fulippo/hatchanger/docs/images/front_body_filamatrix.png

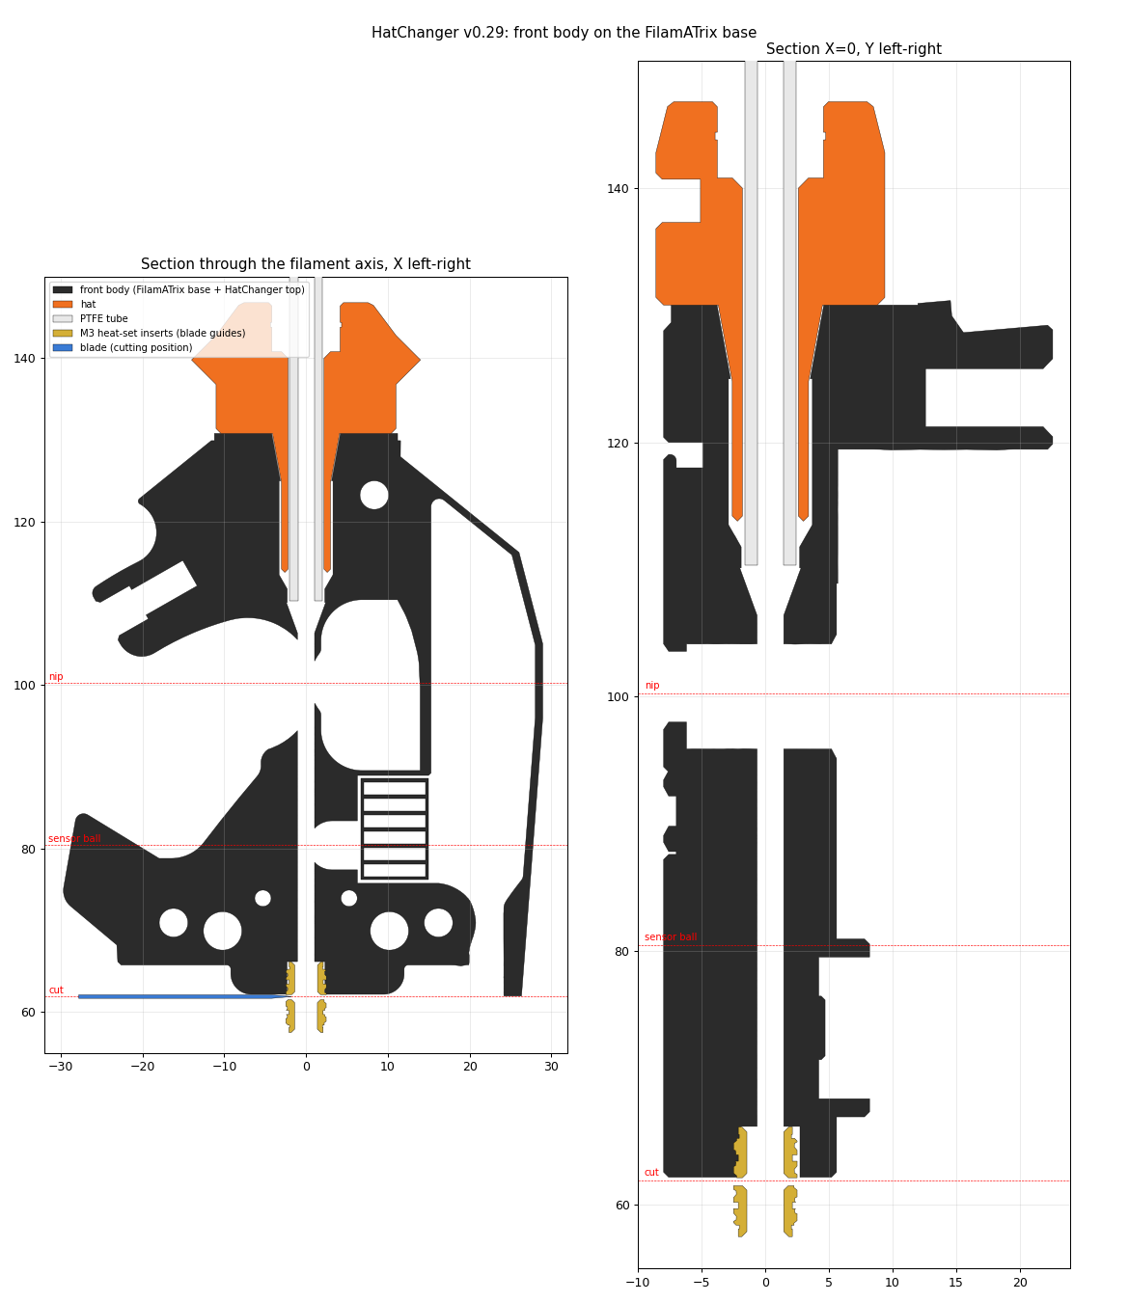
docs/images/front_body_filamatrix.png
