fulippo/hatchanger/docs/images/hat_onepiece_section.png

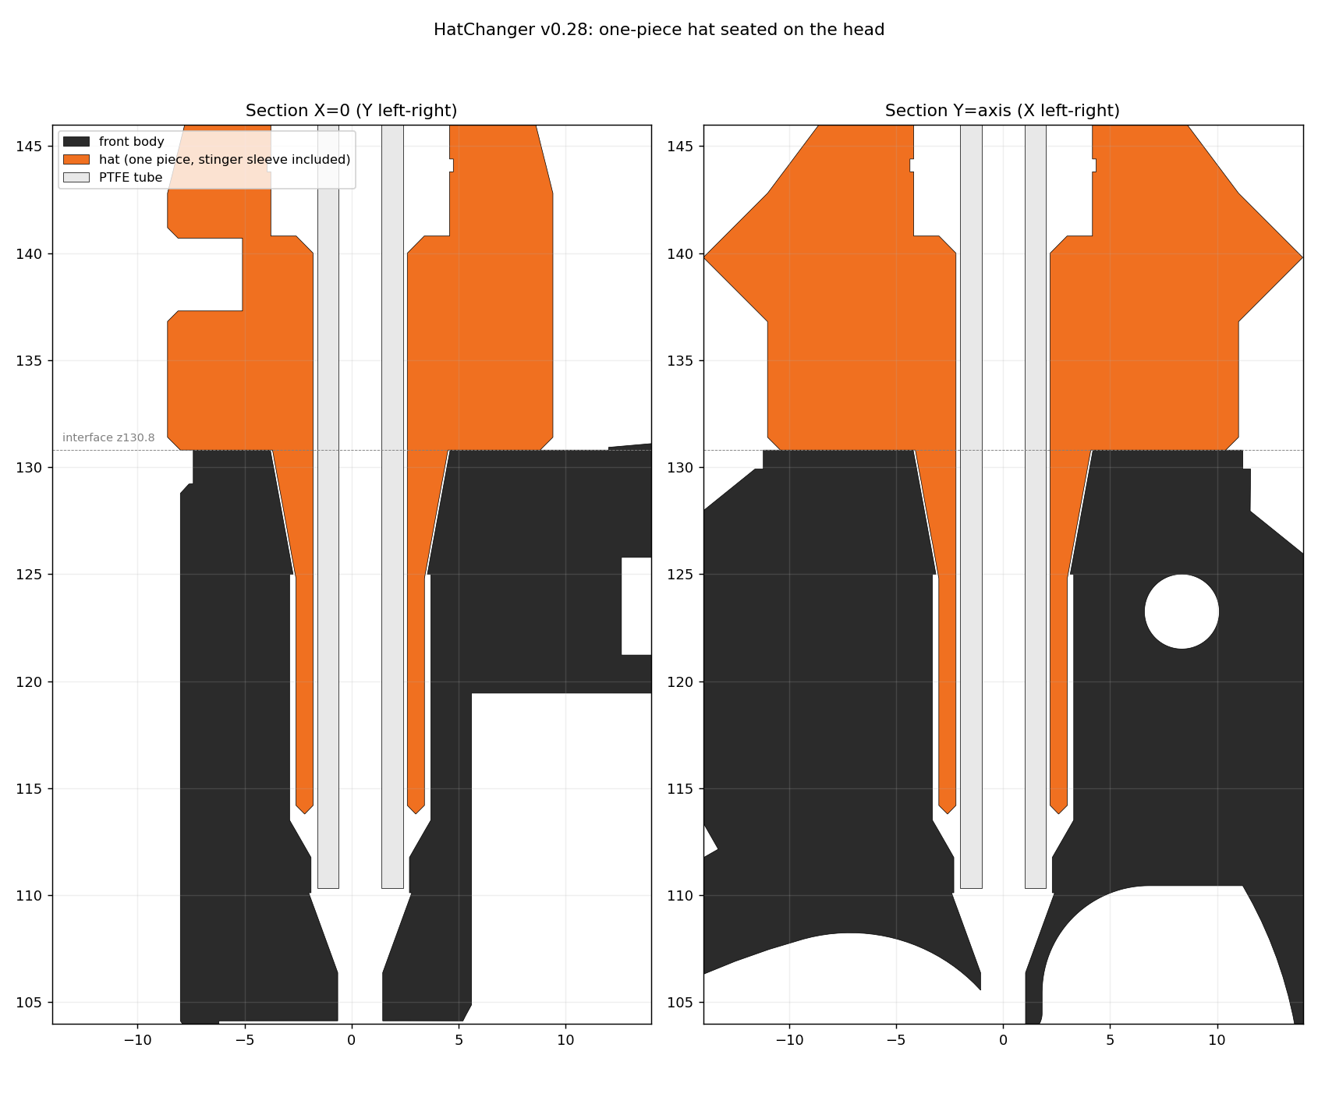
docs/images/hat_onepiece_section.png
