fulippo/hatchanger/docs/images/hat_rack.png

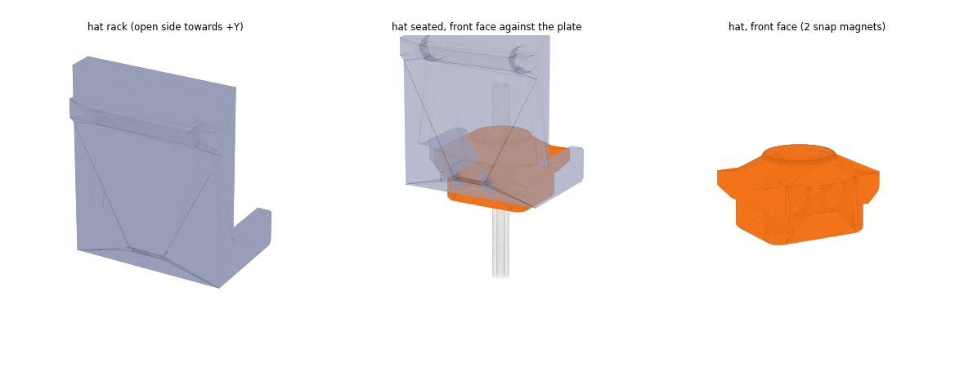
docs/images/hat_rack.png
