fulippo/hatchanger/docs/images/ptfe_rail_clamp.png

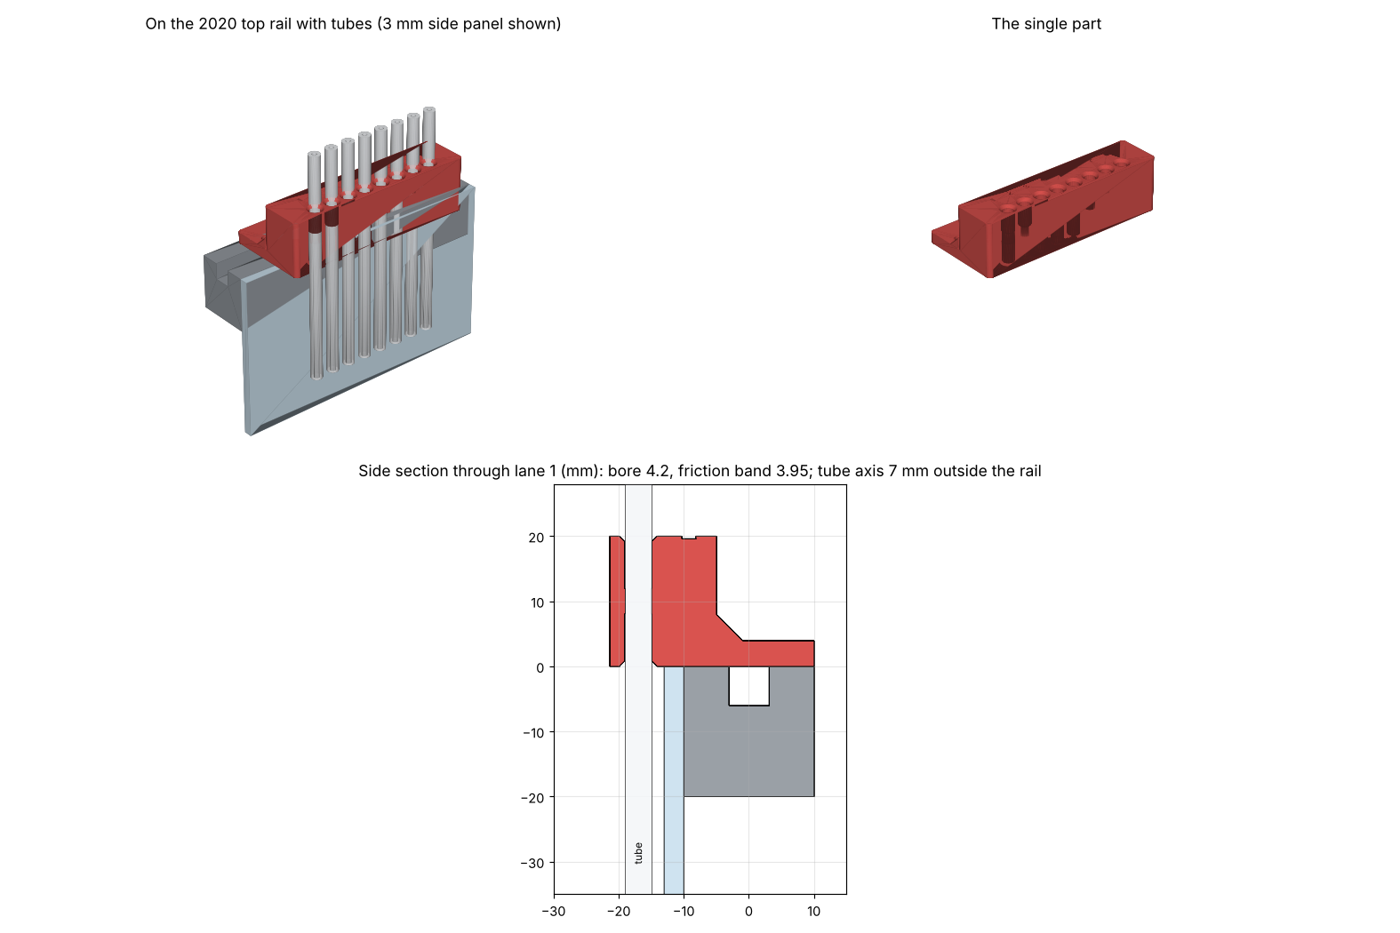
docs/images/ptfe_rail_clamp.png
