fulippo/hatchanger/cad/hatchanger/step/stinger_gauge.step

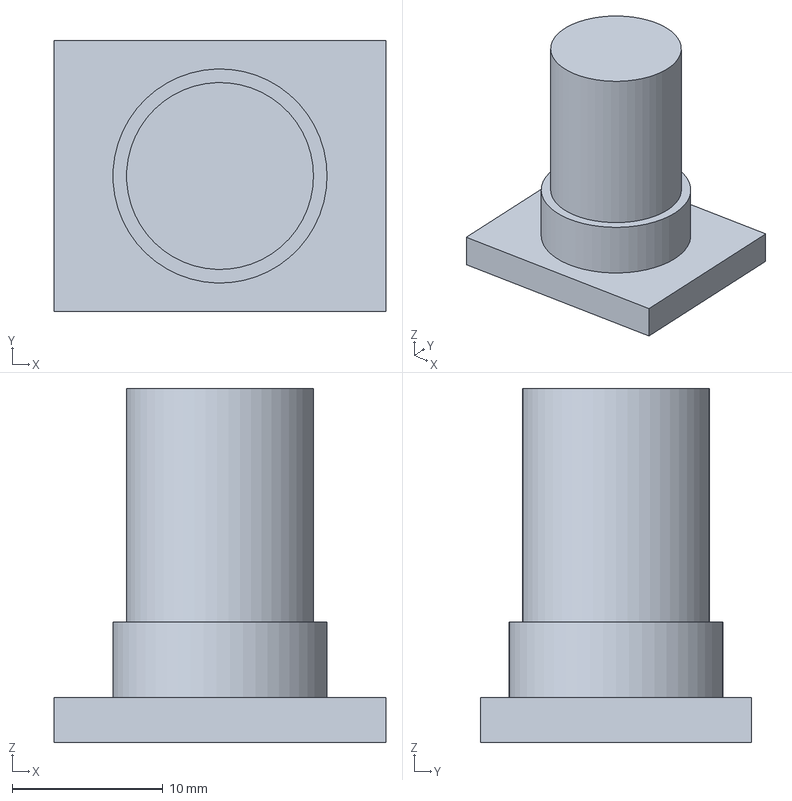
[picture p14: CAD file, 2026-10-16]
cad/hatchanger/step/stinger_gauge.step
22.0 x 18.0 x 23.5 mm
