fulippo/hatchanger/cad/tophat/step/250/tophat_250_centre_rear.step

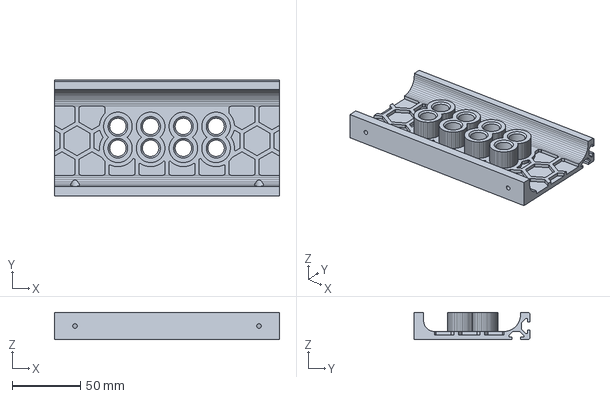
[picture p16: CAD file, 2026-10-20]
cad/tophat/step/250/tophat_250_centre_rear.step
165.0 x 85.0 x 20.0 mm
