fulippo/hatchanger/cad/tophat/step/350/tophat_350_centre_rear.step

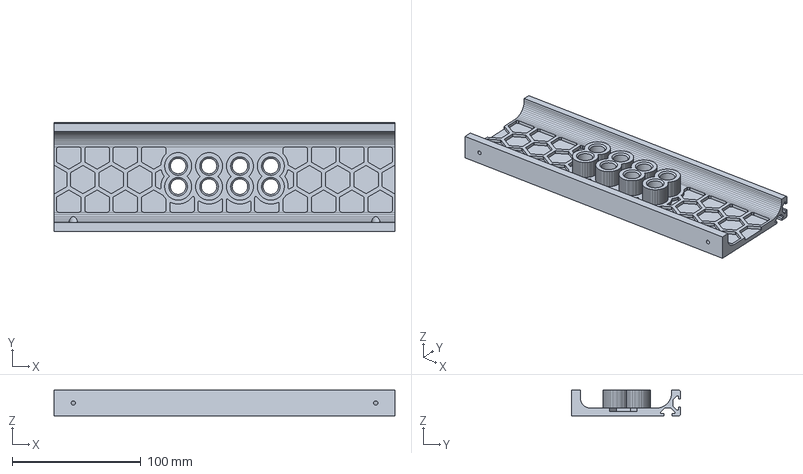
[picture p18: CAD file, 2026-10-20]
cad/tophat/step/350/tophat_350_centre_rear.step
265.0 x 85.0 x 20.0 mm
