fulippo/hatchanger/cad/tophat/step/tophat_grommet_tpu.step

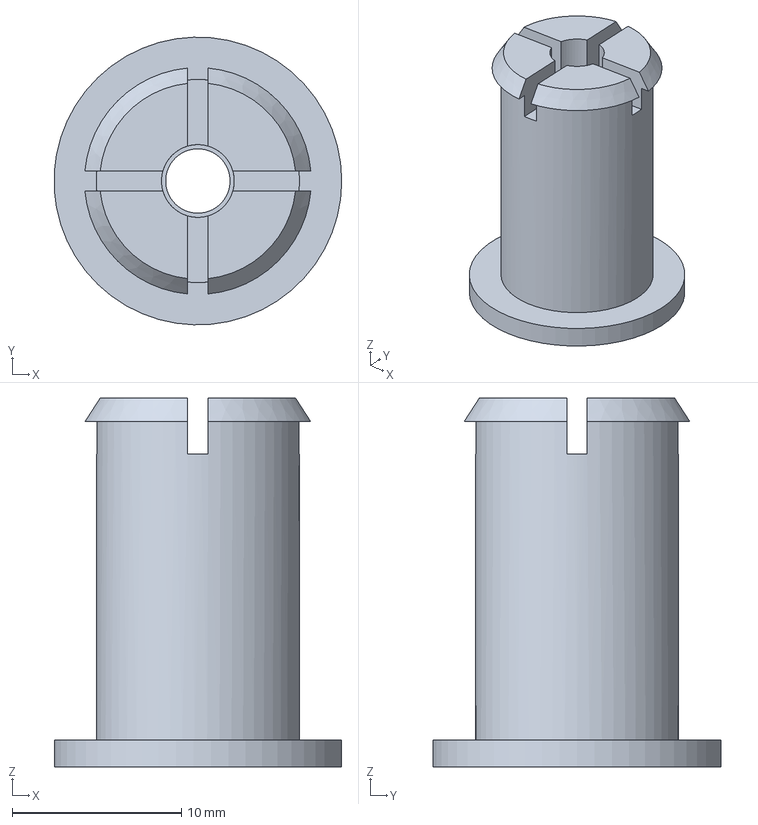
[picture p19: CAD file, 2026-10-20]
cad/tophat/step/tophat_grommet_tpu.step
17.0 x 17.0 x 21.8 mm
