fulippo/hatchanger/cad/hatchanger/step/hat_rack_spacer_12.step

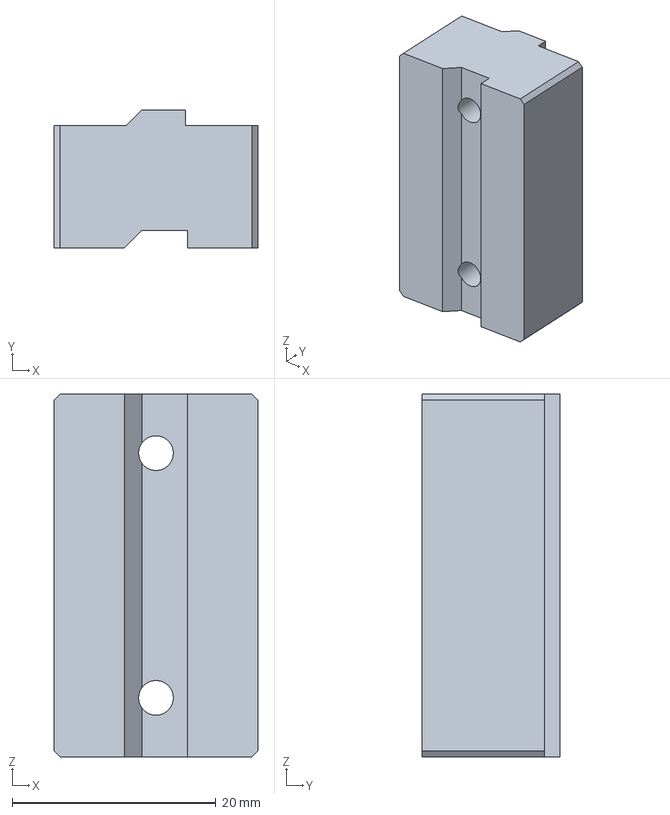
[picture p20: CAD file, 2026-10-16]
cad/hatchanger/step/hat_rack_spacer_12.step
20.0 x 13.5 x 35.6 mm
