fulippo/hatchanger/cad/ptfe_rail_clamp/step/ptfe_rail_clamp_4x.step

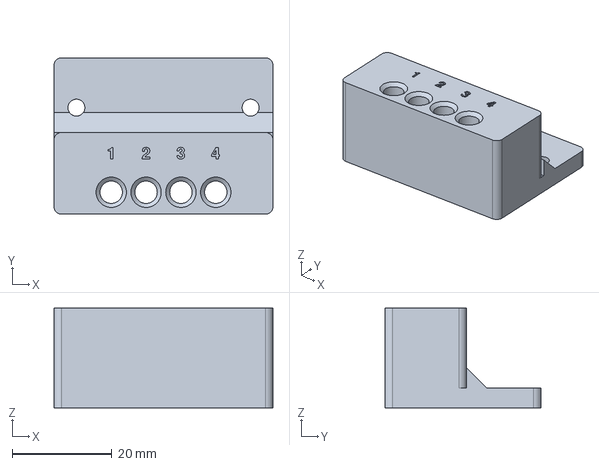
[picture p21: CAD file, 2026-10-16]
cad/ptfe_rail_clamp/step/ptfe_rail_clamp_4x.step
44.0 x 31.4 x 20.0 mm
