fulippo/hatchanger/cad/tophat/step/300/tophat_300_centre_voronoi.step

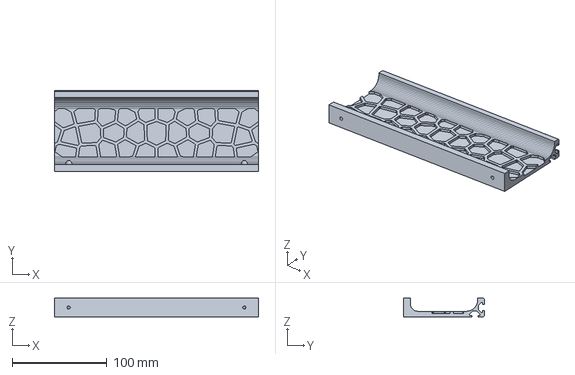
[picture p22: CAD file, 2026-10-20]
cad/tophat/step/300/tophat_300_centre_voronoi.step
215.0 x 85.0 x 20.0 mm
