fulippo/hatchanger/cad/hatchanger/step/hat.step

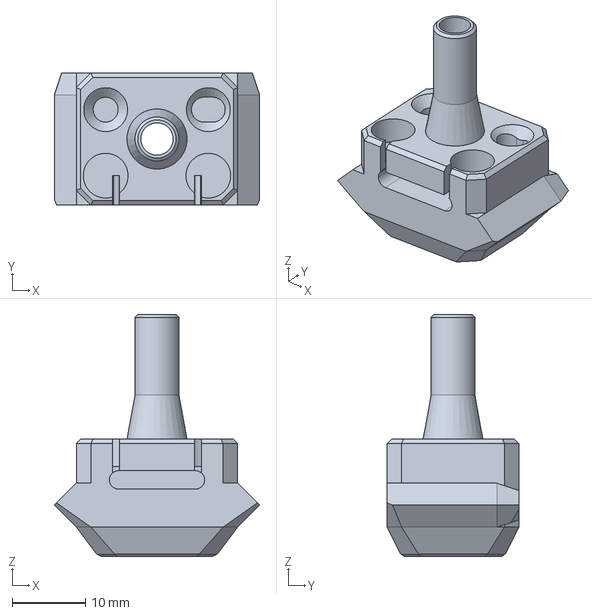
[picture p25: CAD file, 2026-10-16]
cad/hatchanger/step/hat.step
28.0 x 18.0 x 33.0 mm
