fulippo/hatchanger/cad/tophat/step/250/tophat_250_centre_voronoi.step

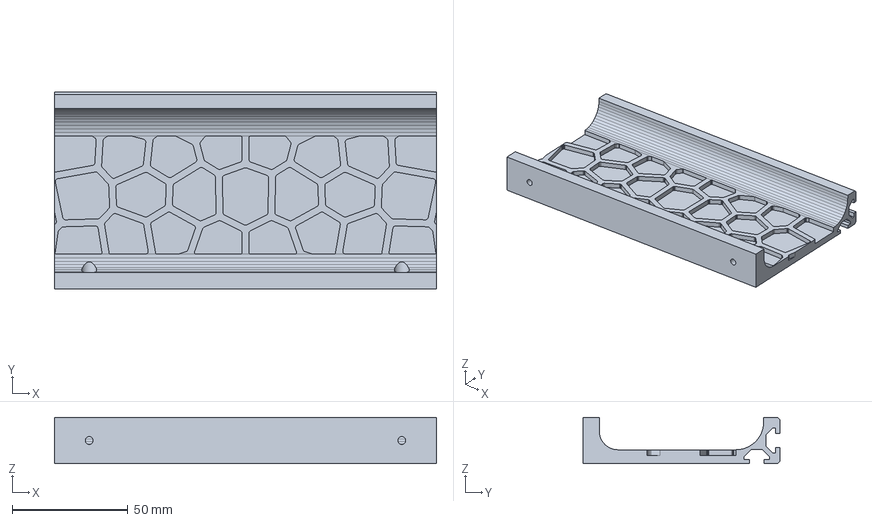
[picture p26: CAD file, 2026-10-20]
cad/tophat/step/250/tophat_250_centre_voronoi.step
165.0 x 85.0 x 20.0 mm
