fulippo/hatchanger/cad/tophat/step/300/tophat_300_centre_front.step

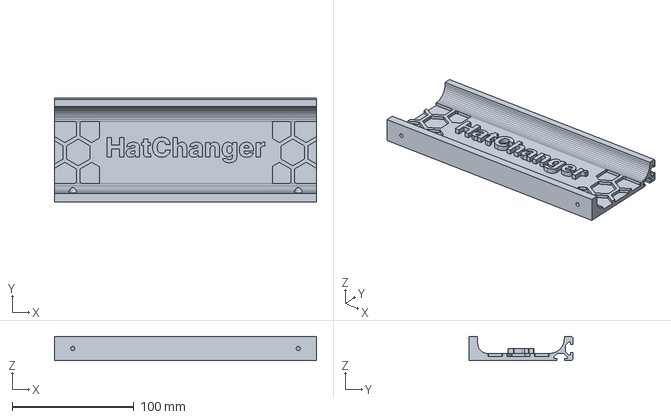
[picture p27: CAD file, 2026-10-20]
cad/tophat/step/300/tophat_300_centre_front.step
215.0 x 85.0 x 20.0 mm
