fulippo/hatchanger/cad/hatchanger/step/front_body_hatchanger.step

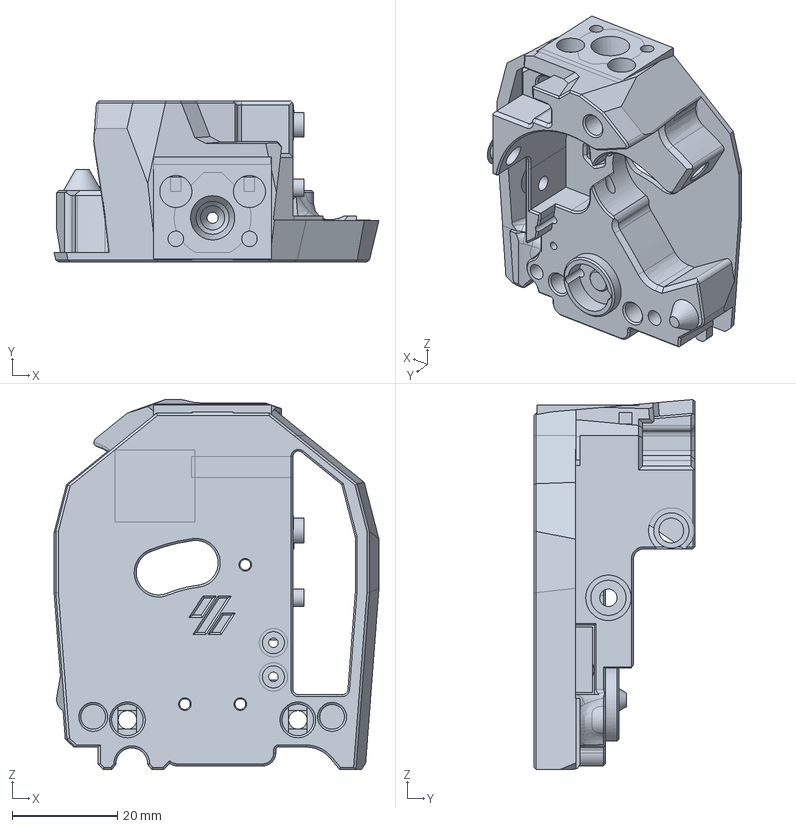
[picture p28: CAD file, 2026-10-16]
cad/hatchanger/step/front_body_hatchanger.step
61.8 x 30.6 x 70.3 mm
