fulippo/hatchanger/cad/tophat/step/250/tophat_250_corner.step

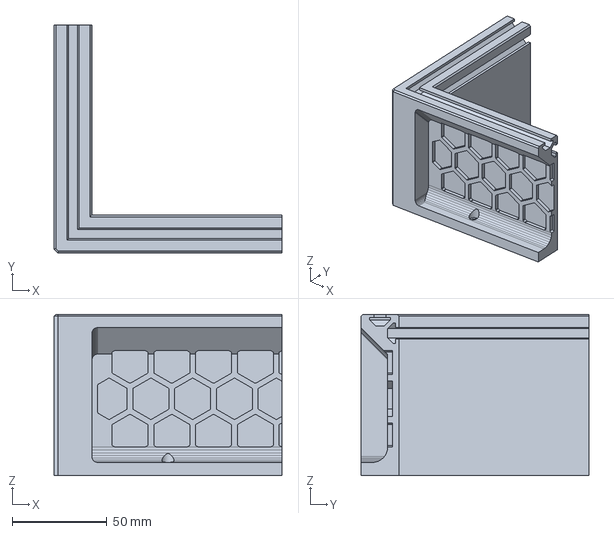
[picture p29: CAD file, 2026-10-20]
cad/tophat/step/250/tophat_250_corner.step
120.0 x 120.0 x 85.0 mm
