fulippo/hatchanger/cad/hatchanger/step/hat_rack.step

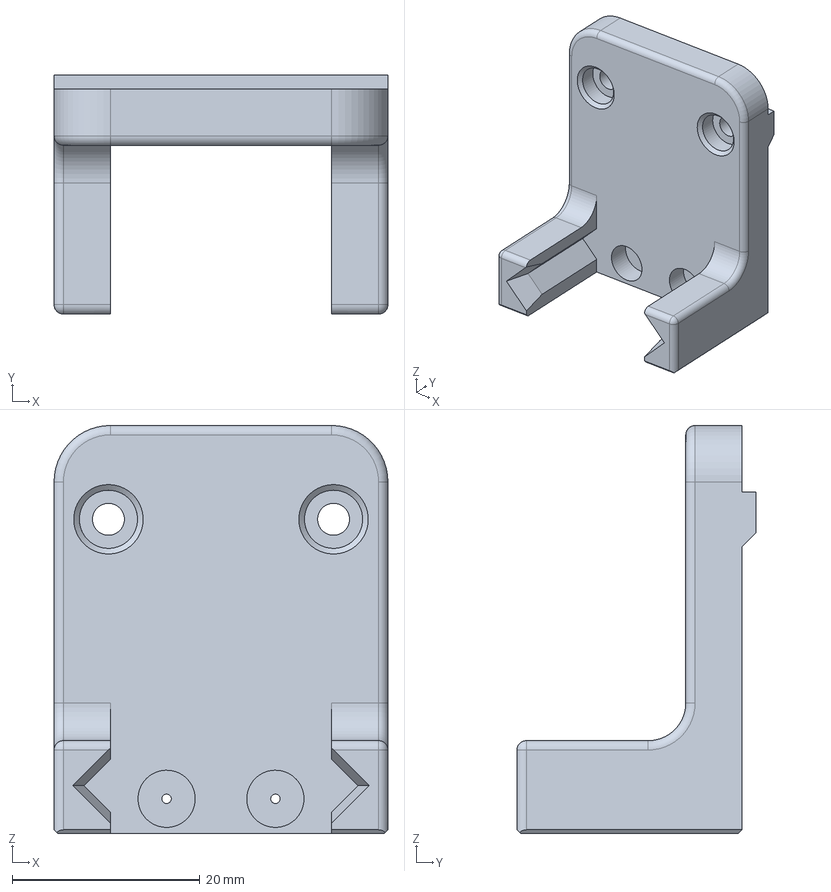
[picture p30: CAD file, 2026-10-16]
cad/hatchanger/step/hat_rack.step
35.6 x 25.5 x 43.5 mm
