fulippo/hatchanger/cad/tophat/step/300/tophat_300_corner_voronoi.step

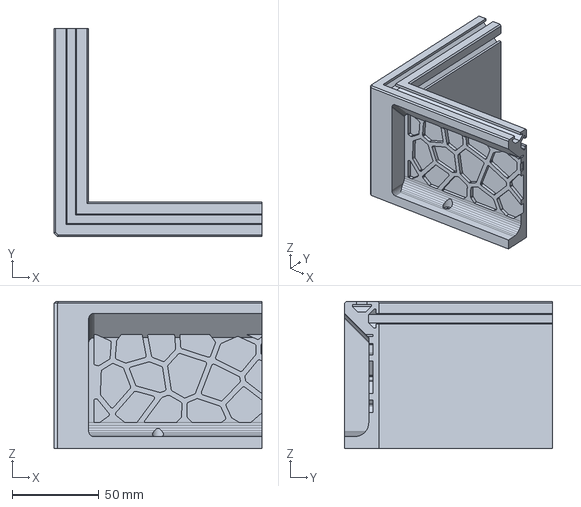
[picture p31: CAD file, 2026-10-20]
cad/tophat/step/300/tophat_300_corner_voronoi.step
120.0 x 120.0 x 85.0 mm
