fulippo/hatchanger/cad/hatchanger/step/hat_rack_spacer_17.step

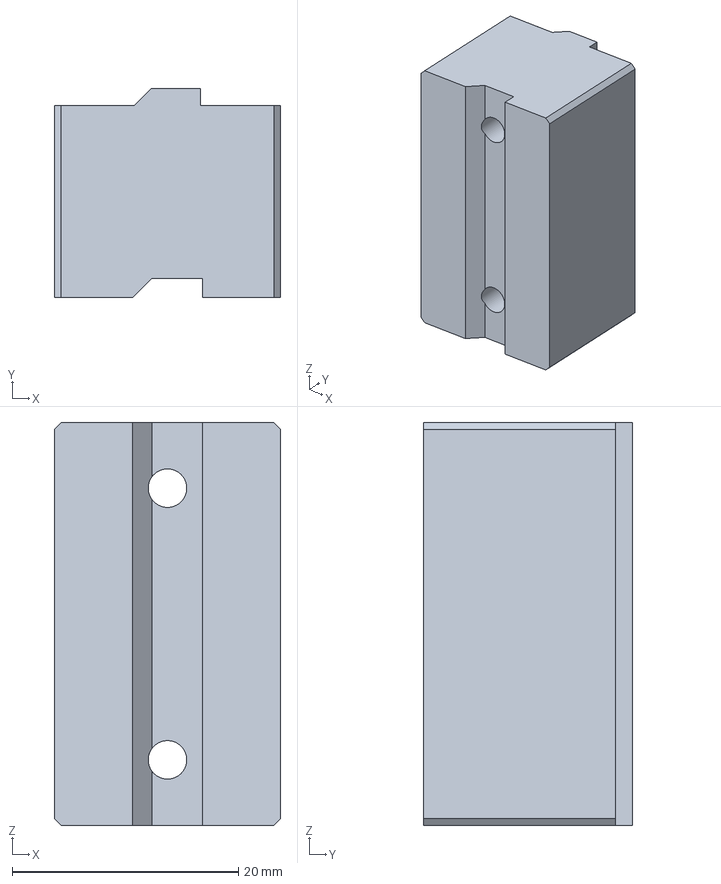
[picture p32: CAD file, 2026-10-16]
cad/hatchanger/step/hat_rack_spacer_17.step
20.0 x 18.5 x 35.6 mm
