fulippo/hatchanger/(list of files, cad)

Other CAD files:
cad/tophat/step/250/tophat_250_centre_rear_voronoi.step
cad/tophat/step/350/tophat_350_centre_front_voronoi.step
cad/tophat/step/300/tophat_300_centre_rear.step
cad/tophat/step/350/tophat_350_centre_front.step
cad/tophat/step/250/tophat_250_centre.step
cad/tophat/step/350/tophat_350_centre.step
cad/tophat/step/300/tophat_300_centre_front_voronoi.step
cad/tophat/step/350/tophat_350_corner_voronoi.step
cad/tophat/step/250/tophat_250_centre_front.step
cad/tophat/step/300/tophat_300_centre.step
cad/tophat/step/350/tophat_350_centre_rear_voronoi.step
cad/tophat/step/250/tophat_250_corner_voronoi.step
cad/tophat/step/300/tophat_300_corner.step
cad/tophat/step/350/tophat_350_corner.step
cad/hatchanger/stl/front_body_hatchanger.stl
cad/hatchanger/stl/hat.stl
cad/hatchanger/stl/hat_rack.stl
cad/hatchanger/stl/hat_rack_spacer_12.stl
cad/hatchanger/stl/hat_rack_spacer_17.stl
cad/hatchanger/stl/stinger_gauge.stl
cad/ptfe_rail_clamp/stl/ptfe_rail_clamp.stl
cad/ptfe_rail_clamp/stl/ptfe_rail_clamp_4x.stl
cad/tophat/stl/250/tophat_250_centre.stl
cad/tophat/stl/250/tophat_250_centre_front.stl
cad/tophat/stl/250/tophat_250_centre_front_voronoi.stl
cad/tophat/stl/250/tophat_250_centre_rear.stl
cad/tophat/stl/250/tophat_250_centre_rear_voronoi.stl
cad/tophat/stl/250/tophat_250_centre_voronoi.stl
cad/tophat/stl/250/tophat_250_corner.stl
cad/tophat/stl/250/tophat_250_corner_voronoi.stl
cad/tophat/stl/300/tophat_300_centre.stl
cad/tophat/stl/300/tophat_300_centre_front.stl
cad/tophat/stl/300/tophat_300_centre_front_voronoi.stl
cad/tophat/stl/300/tophat_300_centre_rear.stl
cad/tophat/stl/300/tophat_300_centre_rear_voronoi.stl
cad/tophat/stl/300/tophat_300_centre_voronoi.stl
cad/tophat/stl/300/tophat_300_corner.stl
cad/tophat/stl/300/tophat_300_corner_voronoi.stl
cad/tophat/stl/350/tophat_350_centre.stl
cad/tophat/stl/350/tophat_350_centre_front.stl
cad/tophat/stl/350/tophat_350_centre_front_voronoi.stl
cad/tophat/stl/350/tophat_350_centre_rear.stl
cad/tophat/stl/350/tophat_350_centre_rear_voronoi.stl
cad/tophat/stl/350/tophat_350_centre_voronoi.stl
cad/tophat/stl/350/tophat_350_corner.stl
cad/tophat/stl/350/tophat_350_corner_voronoi.stl
cad/tophat/stl/tophat_grommet_tpu.stl
cad/tophat/stl/tophat_plug_tpu.stl
