fulippo/hatchanger/CHANGELOG.md

# Changelog

## [0.3.1](https://github.com/fulippo/hatchanger/compare/v0.3.0...v0.3.1) (2026-10-20)

### Bug Fixes

* **klipper:** retract with the hat set down in its rack ([#16](https://github.com/fulippo/hatchanger/issues/16)) ([a5610ed](https://github.com/fulippo/hatchanger/commit/a5610ed465f378f5369afddc163002f0f39cc69a))

## [0.3.0](https://github.com/fulippo/hatchanger/compare/v0.2.1...v0.3.0) (2026-10-19)

### Features

* **cad:** heated-chamber top hat ([#13](https://github.com/fulippo/hatchanger/issues/13)) ([be45531](https://github.com/fulippo/hatchanger/commit/be45531997d22f0eaba598da5beb90167f2b9cf1))

## [0.2.1](https://github.com/fulippo/hatchanger/compare/v0.2.0...v0.2.1) (2026-10-19)

### Bug Fixes

* **install:** never treat a git folder as a release; warn when Moonraker wasn't restarted ([#11](https://github.com/fulippo/hatchanger/issues/11)) ([2aafa21](https://github.com/fulippo/hatchanger/commit/2aafa219eaf577a596d7720efe97df89b4ac7521))

## [0.2.0](https://github.com/fulippo/hatchanger/compare/v0.1.0...v0.2.0) (2026-10-19)

### Features

* **install:** update from release zips ([#9](https://github.com/fulippo/hatchanger/issues/9)) ([0c562e2](https://github.com/fulippo/hatchanger/commit/0c562e2db3e7753bdfed7bfccc013925862903b3))

## 0.1.0 (2026-10-16)

### Bug Fixes

* **klipper:** simplify config comments, drop stale version numbers ([#6](https://github.com/fulippo/hatchanger/issues/6)) ([032e8ab](https://github.com/fulippo/hatchanger/commit/032e8ab36db742e6925a46bb73a34108242cff49))

## Changelog

Changes to the Klipper macros, the AFC unit and the installer. This file is maintained by
[release-please](https://github.com/googleapis/release-please) from
[Conventional Commits](https://www.conventionalcommits.org/); don't edit it by hand.
