fulippo/hatchanger/(commit log)

2026-10-16 Initial public release
    [afc_test_printer.cfg, front_body_hatchanger.step, front_body_hatchanger.stl, hat.step, hat.stl, hat_rack.step, hat_rack.stl, hat_rack_spacer_12.step]
2026-10-16 docs(bom): remove prices
2026-10-16 fix(klipper): simplify config comments, drop stale version numbers (#6)
    [hatchanger.cfg, hatchanger_afc.cfg, hatchanger_id.cfg, hatchanger_tools.cfg]
2026-10-19 feat(install): update from release zips (#9)
    * feat(install): Moonraker updates from release zips
    Each release gets hatchanger.zip (installer, Klipper config, AFC unit, docs;
    no CAD) plus hatchanger-stl-<tag>.zip, built by scripts/release_zip.py in the
    release workflow. Installed from the release zip, install.sh registers
    [update_manager hatchanger] as type: zip (stable, or --beta for pre-releases);
    a git clone keeps type: git_repo on its branch. Docs explain both and how to
    switch from a clone to releases.
    * feat(install): always update from release zips
    Drop the git_repo update type: Moonraker always manages HatChanger as type zip.
    Run from a git clone, install.sh fetches the latest rel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
2026-10-19 feat(cad): heated-chamber top hat (#13)
    * feat(cad): heated-chamber top hat
    An 85 mm canopy wall on the top extrusions that raises the stock top panel
    above the loaded hat's bowden arc.
    - 20 mm footprint, same as the frame; the top 20 mm is a printed 2020 with
    T-slots on top, outside and inside for panel clips and accessories
    - 2.5 mm gaps between pieces for foam strips
    - 4 corners, 2 side centres, front centre with a HatChanger plaque, rear
    centre with 8 grommeted bowden exits; every piece fits a 300 bed
    - screwed to the frame's top slots (M3 x 10 + roll-in T-nuts) through
    shafts reached from the printed top slot
    - honeycomb panels, voronoi variant with --pattern voronoi
    * feat(cad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
    [front_body_hatchanger.step, front_body_hatchanger.stl, hat.step, hat.stl, hat_rack.step, hat_rack.stl, hat_rack_spacer_12.step, hat_rack_spacer_12.stl]
2026-10-20 feat(cad): lighter top hat (#15)
    * feat(cad): lighter top hat, screws from the bottom
    - Hollowed from the outside: a deep tray below the top band with the
    honeycomb on a 3.5 mm skin; the inner face is flat. Full 20 mm only at
    the top band, the foot, the corner columns, the piece ends and the bosses
    round the bowden exits; the front letters stand on the tray floor.
    - Centres print lying on their inner face; corners print upright (45° tray
    roofs).
    - Frame screws go through the 5 mm foot from pockets at the bottom of the
    outer face (short L-key): no more shafts from the top slot, the side
    slots run uninterrupted.
    Model volume of a 300 set 2447 -> 1449 cm3.
    * feat(cad): top hat t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
    [tophat_250_centre.step, tophat_250_centre.stl, tophat_250_centre_front.step, tophat_250_centre_front.stl, tophat_250_centre_front_voronoi.step, tophat_250_centre_front_voronoi.stl, tophat_250_centre_rear.step, tophat_250_centre_rear.stl]
2026-10-20 fix(klipper): retract with the hat set down in its rack (#16)
    The post-cut pull and the pre-park ran at the cutter, with only the head's
    magnets holding the hat. At a steep bowden angle the drag on the filament
    lifted the hat off. HAT_DOCK now slides the hat into its rack and sets it on
    the lower lips first, then retracts: the upper lips hold the hat down.
    If the pre-park fails there, the head stays in the rack (_HAT_STATE.docking)
    and every command that moves refuses to start; HAT_DOCK run again finishes
    the dock from the pre-park. Adds a batch-mode test for that resume.
    [hatchanger.cfg]
